LoZioo/Domoticata/README.md

# Domoticata
Custom domotic home system.
