LoZioo/Domoticata/docs/Schema funzionale/Schema funzionale.pdf

AC/DC
12V

AC
220V

ESP32

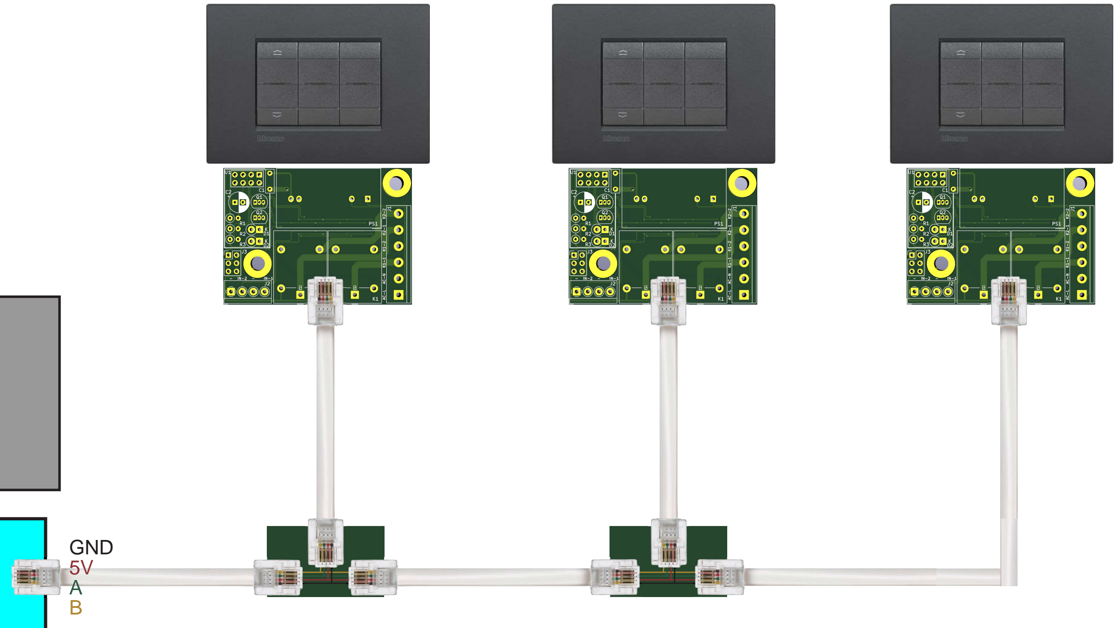
[picture p1: figure]
GND 5VAB

Centralina
