LoZioo/Domoticata/docs/PowerMonitor.docx

P(W)=1/n∑_(i=1)^n (V_i *I_i )

S(VA)=V_(RMS) *I_(RMS)

Q(VAr)=√(S^2 -P^2)

cosφ=P/S
