LoZioo/Domoticata/hardware/img/GND.png

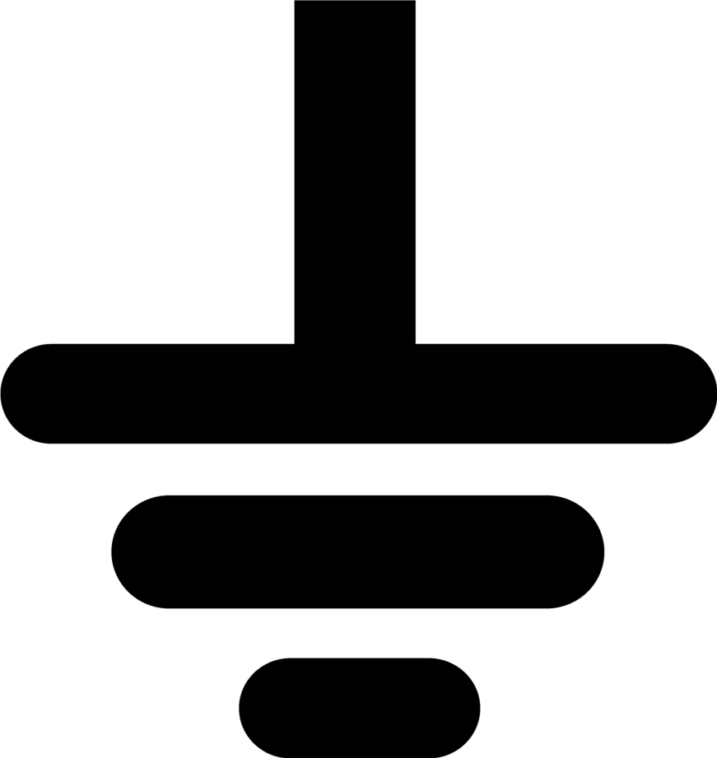
hardware/img/GND.png
