LoZioo/Domoticata/hardware/schematics/DIN_panel/DIN_panel.kicad_pcb

## KiCad design hardware/schematics/DIN_panel/DIN_panel.kicad_pcb (2024-09-18)

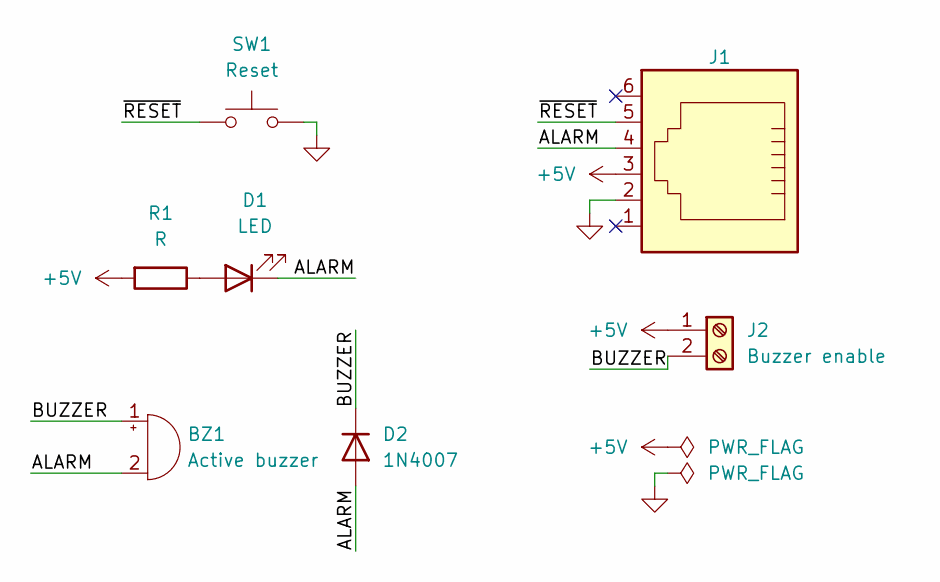
[picture p3: schematic DIN_panel.kicad_sch, Domoticata DIN panel]

Parts:
BZ1: Active buzzer; Buzzer_12x9.5RM7.6
D1: LED; LED_D5.0mm
D2: 1N4007; D_DO-41_SOD81_P7.62mm_Horizontal
J1: 6P6C; RJ25_Wayconn_MJEA-660X1_Horizontal
J2: Buzzer enable; TerminalBlock_4Ucon_1x02_P3.50mm_Horizontal
R1: R; R_Axial_DIN0207_L6.3mm_D2.5mm_P7.62mm_Horizontal
SW1: Reset; SW_PUSH_6mm_H5mm

Connections:
+5V: J1.3, J2.1, R1.2
/ALARM: BZ1.2 (-), D1.1 (K), D2.2 (A), J1.4
/BUZZER: BZ1.1 (+), D2.1 (K), J2.2
/~RESET: J1.5, SW1.1
GND: J1.2, SW1.2
unnamed: D1.2 (A), R1.1

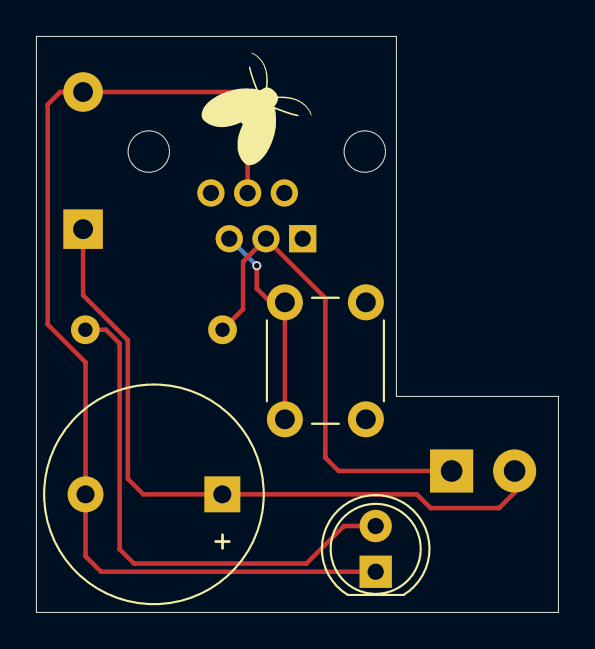
[picture p4: board DIN_panel.kicad_pcb from above]

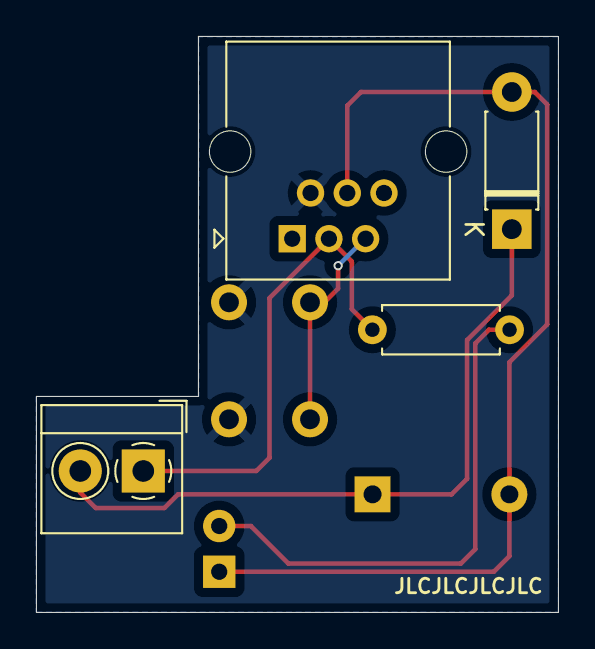
[picture p5: board DIN_panel.kicad_pcb from below]

Board: 2 copper layers, 29.0 x 32.0 mm, 7 parts (4 on the bottom side), 6 nets.
