LoZioo/Domoticata/hardware/schematics/wall_terminal/wall_terminal.kicad_pcb

## KiCad design hardware/schematics/wall_terminal/wall_terminal.kicad_pcb (2024-09-18)

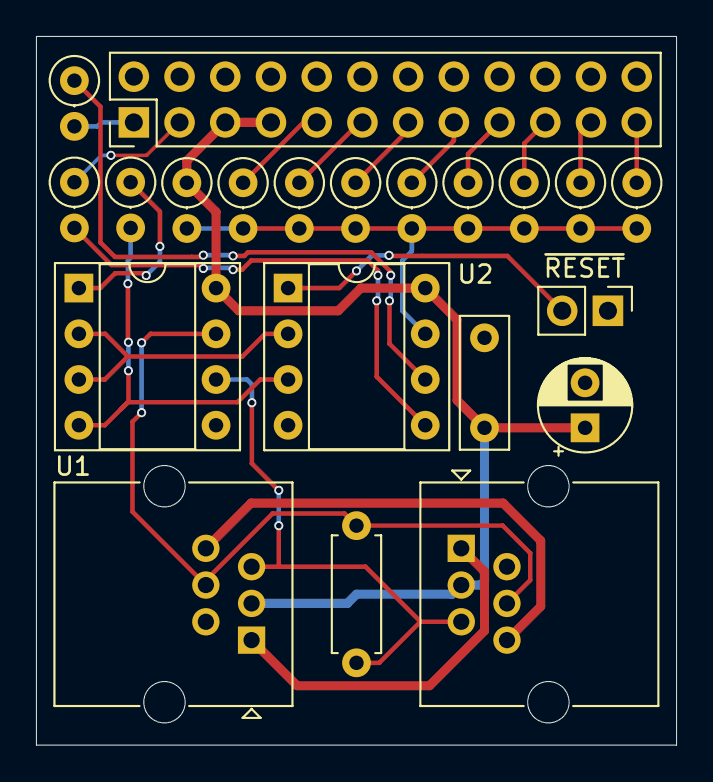
[picture p6: board wall_terminal.kicad_pcb from above]

Board: 2 copper layers, 35.6 x 39.4 mm, 21 parts (0 on the bottom side), 23 nets.

Parts:
C1: 10uF; CP_Radial_D5.0mm_P2.50mm
C2: 100nF; C_Rect_L7.2mm_W2.5mm_P5.00mm_FKS2_FKP2_MKS2_MKP2
J1: Reset; PinHeader_1x02_P2.54mm_Vertical
J2: Conn_02x12_Odd_Even; PinHeader_2x12_P2.54mm_Vertical
J3, J4: 6P6C; RJ25_Wayconn_MJEA-660X1_Horizontal
R1, R2, R3, R4, R5, R6, R7, R8, R9, R10, R11: R; R_Axial_DIN0207_L6.3mm_D2.5mm_P2.54mm_Vertical
R12: 1k; R_Axial_DIN0207_L6.3mm_D2.5mm_P2.54mm_Vertical
R13: 120; R_Axial_DIN0207_L6.3mm_D2.5mm_P7.62mm_Horizontal
U1: MAX487E; DIP-8_W7.62mm_Socket
U2: ATtiny13A-P; DIP-8_W7.62mm_Socket

Connections:
+5V: C1.1, C2.1, J2.5, J2.7, J3.3, J4.3, R11.1, U1.8 (VCC), U2.8 (VCC)
/BUS_SHORT_1: J3.1, J4.1
/BUS_SHORT_6: J3.6, J4.6
/IN/ADC: R3.2, R4.2, R5.2, R6.2, R7.2, R8.2, R9.2, R10.2, R11.2, U2.7 (PB2)
/IN/S1: J2.23, R3.1
/IN/S2: J2.21, R4.1
/IN/S3: J2.19, R5.1
/IN/S4: J2.17, R6.1
/IN/S5: J2.15, R7.1
/IN/S6: J2.13, R8.1
/IN/S7: J2.11, R9.1
/IN/S8: J2.9, R10.1
/MCU/DE/~RE: U1.2 (~RE), U1.3 (DE), U2.2 (PB3)
/MCU/PWM_A: R1.2, U2.5 (PB0)
/MCU/PWM_B: R2.1, U2.6 (PB1)
/MCU/RX/TX: R12.2, U1.4 (DI), U2.3 (PB4)
/MCU/~RST: J1.2, U2.1 (~RESET/PB5)
/RS485_A: J3.5, J4.5, R13.1, U1.6 (A)
/RS485_B: J3.4, J4.4, R13.2, U1.7 (B)
GND: C1.2, C2.2, J1.1, J2.2, J2.4, J2.6, J2.8, J2.10, J2.12, J2.14, J2.16, J2.18, J2.20, J2.22, J2.24, J3.2, J4.2, U1.5 (GND), U2.4 (GND)
unnamed: J2.1, R2.2
unnamed: J2.3, R1.1
unnamed: R12.1, U1.1 (RO)
