LoZioo/Domoticata/hardware/schematics/control_unit/control_unit.kicad_pcb

## KiCad design hardware/schematics/control_unit/control_unit.kicad_pcb (2024-09-18)

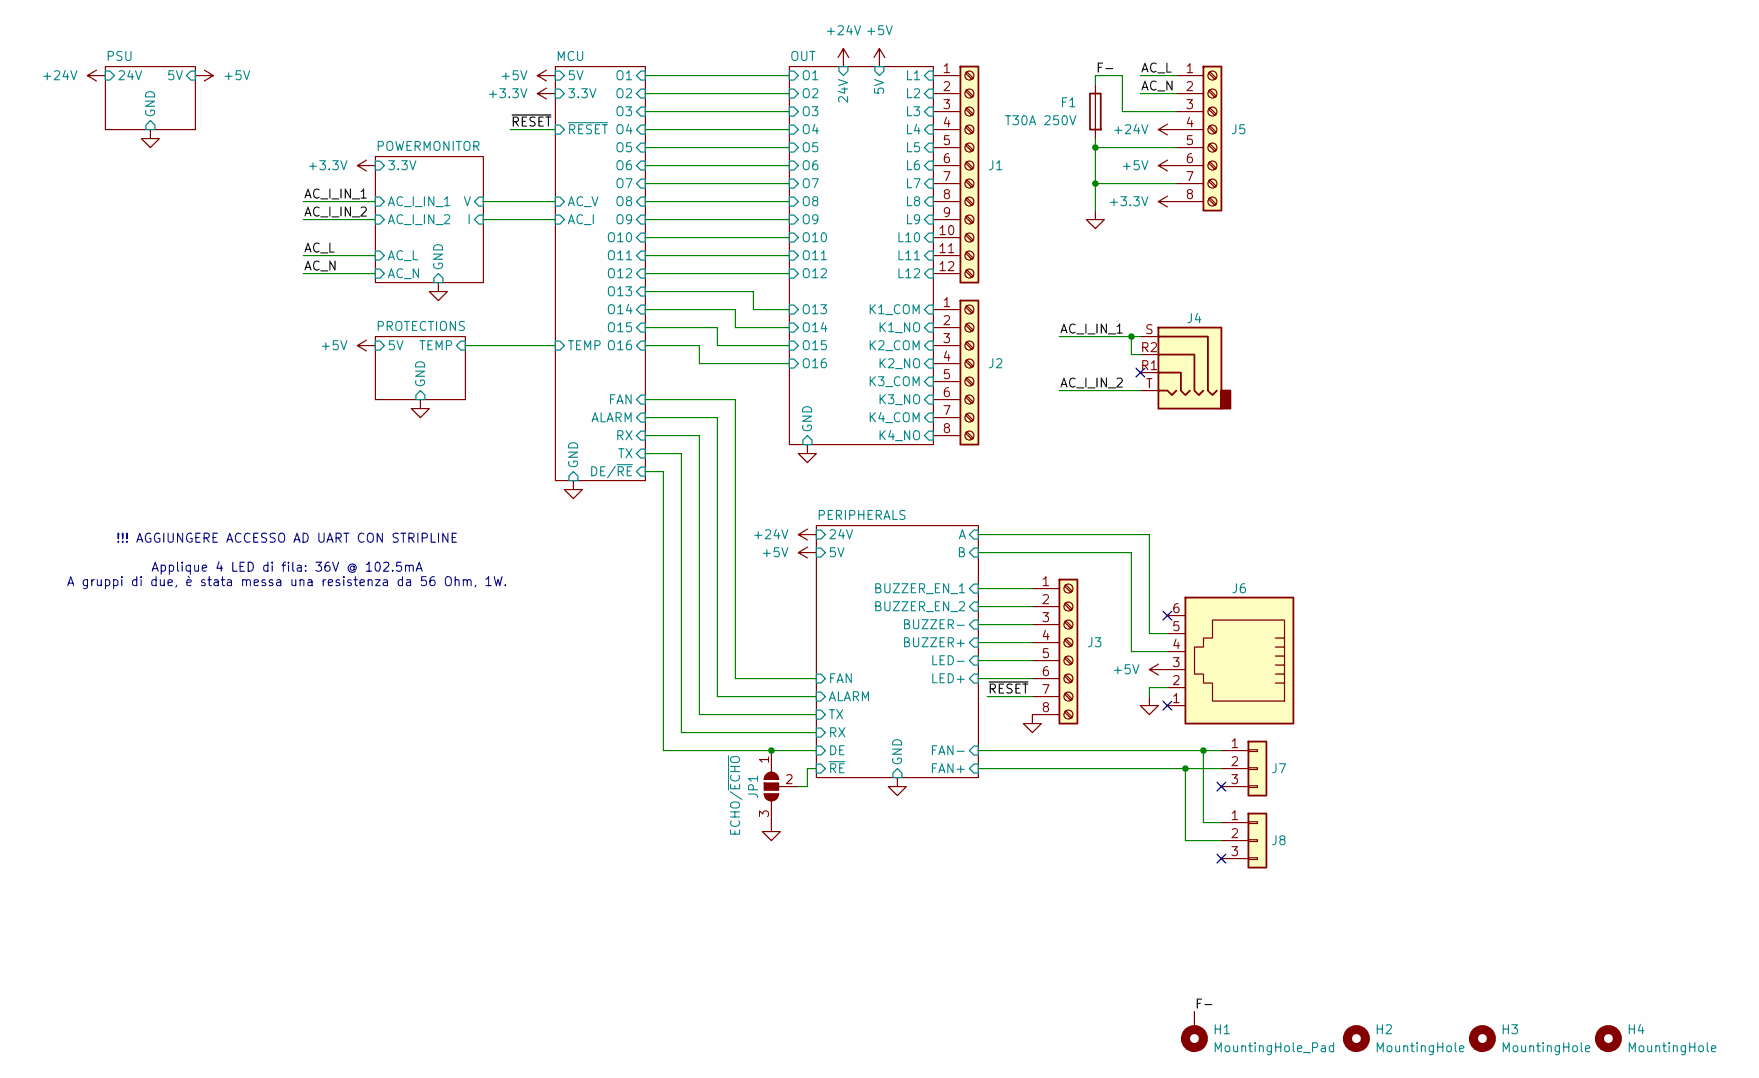
[picture p7: schematic control_unit.kicad_sch, Domoticata main control unit]

Parts:
F1: T30A 250V; Fuseholder_Clip-6.3x32mm_Littelfuse_102_Inline_P34.21x7.62m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
H1: MountingHole_Pad; MountingHole_4.5mm_Pad_TopBottom
H2, H3, H4: MountingHole; MountingHole_4.5mm_Pad_TopBottom
J1: Screw_Terminal_01x12; PhoenixContact_MCV_1,5_12-G-3.81_1x12_P3.81mm_D1.4mm_Vertic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
J2, J3, J5: Screw_Terminal_01x08; PhoenixContact_MCV_1,5_8-G-3.81_1x08_P3.81mm_D1.4mm_Vertical
J4: AudioJack4; SCT013
J6: 6P6C; RJ25_Wayconn_MJEA-660X1_Horizontal
J7, J8: Conn_01x03_Pin; FanPinHeader_1x03_P2.54mm_Vertical
JP1: ECHO/~{ECHO}; SolderJumper-3_P1.3mm_Open_Pad1.0x1.5mm

Connections:
+3.3V: J5.8; also elsewhere on the board
+5V: J3.4, J3.6, J5.6, J6.3; also elsewhere on the board
+24V: J5.4, J7.2, J8.2; also elsewhere on the board
/AC_I_IN_1: J4.R2, J4.S; also elsewhere on the board
/AC_I_IN_2: J4.T; also elsewhere on the board
/AC_L: J5.1; also elsewhere on the board
/AC_N: J5.2; also elsewhere on the board
/F-: F1.1, H1.1, J5.3
/MCU/DE/~RE: JP1.1 (A); also elsewhere on the board
/OUT/K1_COM: J2.1; also elsewhere on the board
/OUT/K1_NO: J2.2; also elsewhere on the board
/OUT/K2_COM: J2.3; also elsewhere on the board
/OUT/K2_NO: J2.4; also elsewhere on the board
/OUT/K3_COM: J2.5; also elsewhere on the board
/OUT/K3_NO: J2.6; also elsewhere on the board
/OUT/K4_COM: J2.7; also elsewhere on the board
/OUT/K4_NO: J2.8; also elsewhere on the board
/OUT/L1: J1.1; also elsewhere on the board
/OUT/L2: J1.2; also elsewhere on the board
/OUT/L3: J1.3; also elsewhere on the board
/OUT/L4: J1.4; also elsewhere on the board
/OUT/L5: J1.5; also elsewhere on the board
/OUT/L6: J1.6; also elsewhere on the board
/OUT/L7: J1.7; also elsewhere on the board
/OUT/L8: J1.8; also elsewhere on the board
/OUT/L9: J1.9; also elsewhere on the board
/OUT/L10: J1.10; also elsewhere on the board
/OUT/L11: J1.11; also elsewhere on the board
/OUT/L12: J1.12; also elsewhere on the board
/PERIPHERALS/A: J6.5; also elsewhere on the board
/PERIPHERALS/B: J6.4; also elsewhere on the board
/PERIPHERALS/BUZZER-: J3.1, J3.3
/PERIPHERALS/BUZZER_EN_2: J3.2; also elsewhere on the board
/PERIPHERALS/FAN-: J7.1, J8.1; also elsewhere on the board
/PERIPHERALS/LED-: J3.5; also elsewhere on the board
/PERIPHERALS/~RE: JP1.2 (C); also elsewhere on the board
/~RESET: J3.7; also elsewhere on the board
GND: F1.2, J3.8, J5.5, J5.7, J6.2, JP1.3 (B); also elsewhere on the board

Notes on the sheet:
!!! AGGIUNGERE ACCESSO AD UART CON STRIPLINE Applique 4 LED di fila: 36V @ 102.5mA A gruppi di due, è stata messa una resistenza da 56 Ohm, 1W.

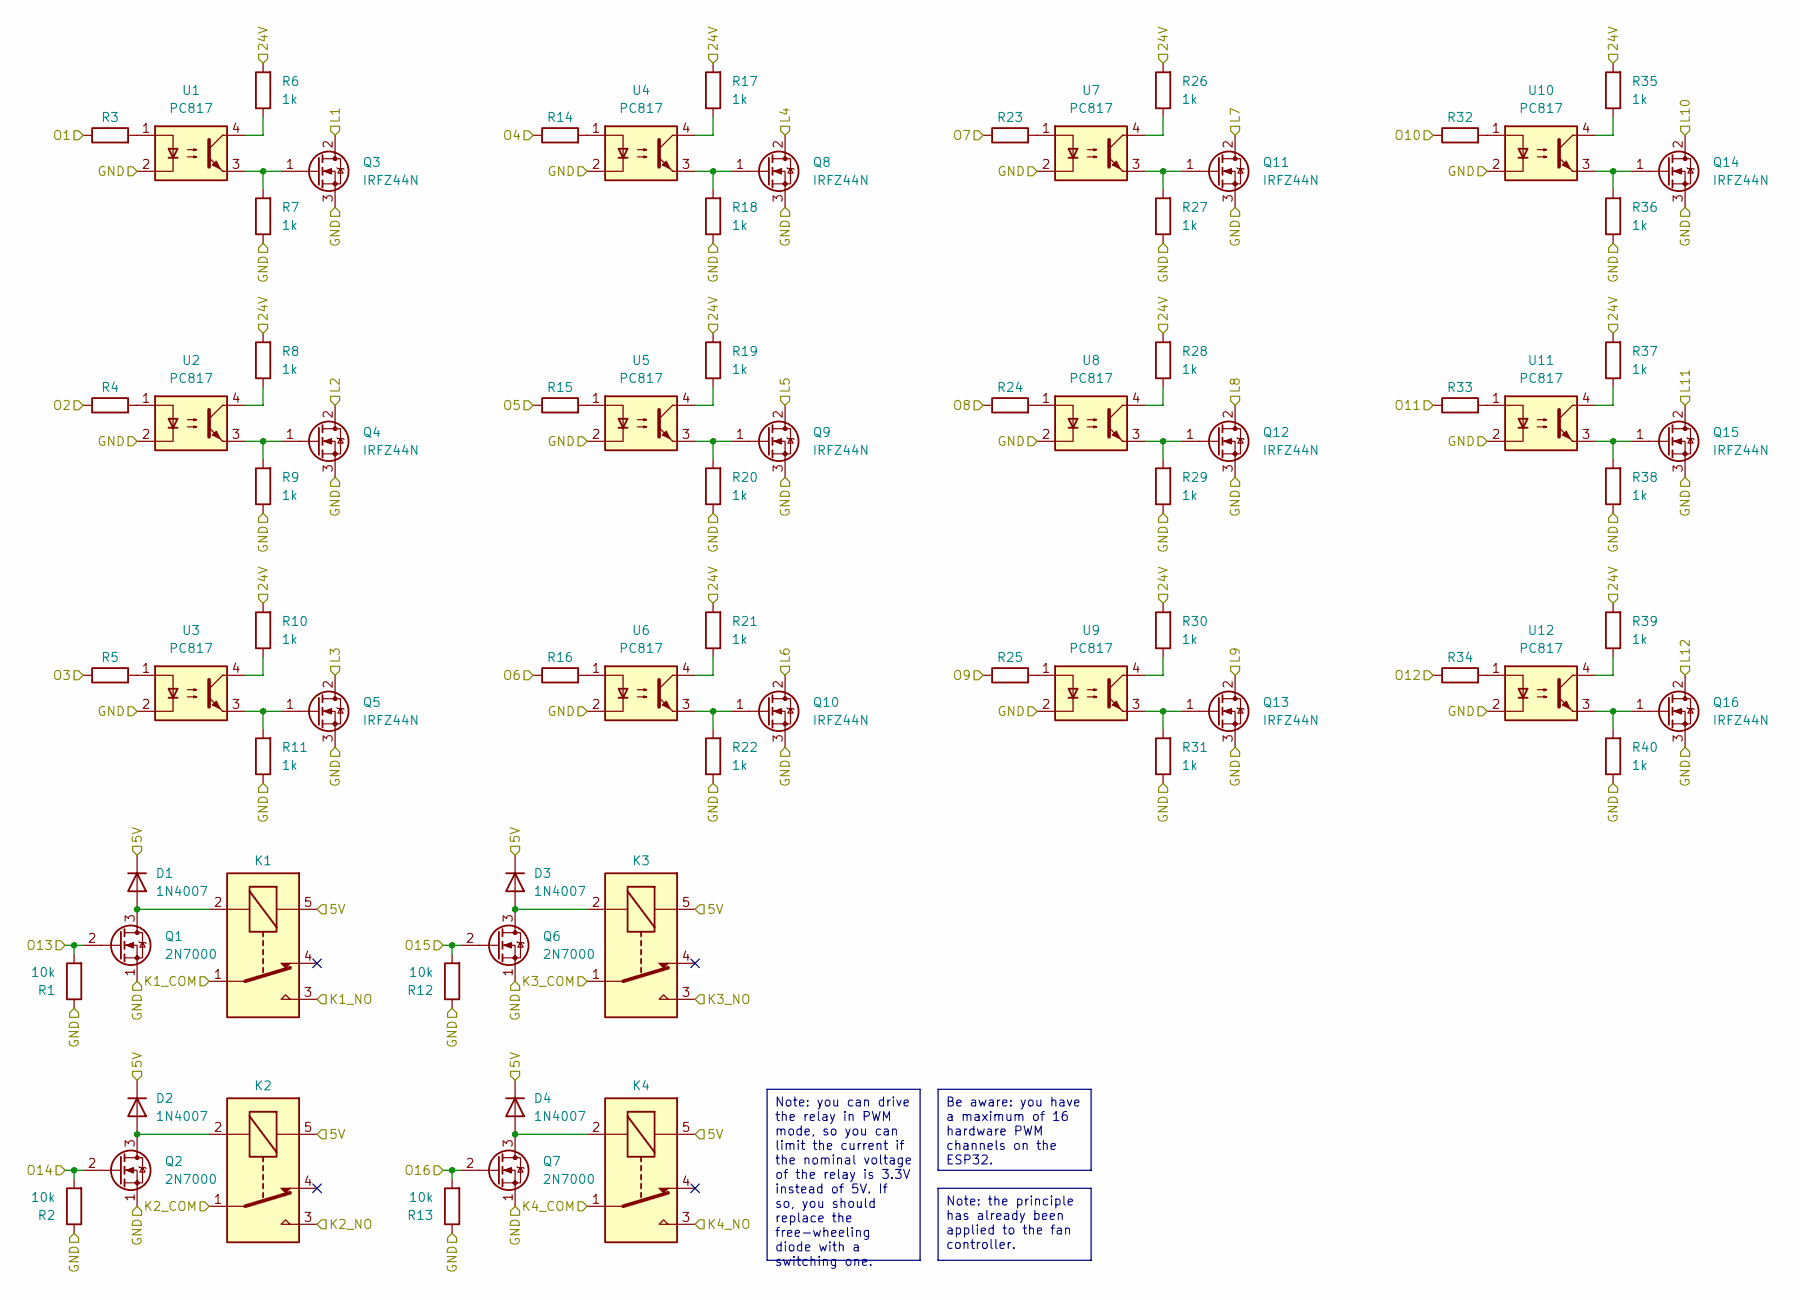
[picture p8: schematic out.kicad_sch, Domoticata main control unit]

Parts:
D1, D2, D3, D4: 1N4007; D_DO-41_SOD81_P7.62mm_Horizontal
K1, K2, K3, K4: Relay_SPDT; Relay_SPDT_Omron-G5LE-1
Q1, Q2, Q6, Q7: 2N7000; TO-92_Inline
Q3, Q4, Q5, Q8, Q9, Q10, Q11, Q12, Q13, Q14, Q15, Q16: IRFZ44N; TO-220-3_Vertical
R1, R2, R12, R13: 10k; R_Axial_DIN0207_L6.3mm_D2.5mm_P7.62mm_Horizontal
R3, R4, R5, R14, R15, R16, R23, R24, R25, R32, R33, R34: R; R_Axial_DIN0207_L6.3mm_D2.5mm_P7.62mm_Horizontal
R6, R7, R8, R9, R10, R11, R17, R18, R19, R20, R21, R22, R26, R27, R28, R29, R30, R31, R35, R36, R37, R38, R39, R40: 1k; R_Axial_DIN0207_L6.3mm_D2.5mm_P7.62mm_Horizontal
U1, U2, U3, U4, U5, U6, U7, U8, U9, U10, U11, U12: PC817; DIP-4_W7.62mm

Connections:
+5V: D1.1 (K), D2.1 (K), D3.1 (K), D4.1 (K), K1.5, K2.5, K3.5, K4.5; also elsewhere on the board
+24V: R6.2, R8.2, R10.2, R17.2, R19.2, R21.2, R26.2, R28.2, R30.2, R35.2, R37.2, R39.2; also elsewhere on the board
/MCU/O1: R3.1; also elsewhere on the board
/MCU/O2: R4.1; also elsewhere on the board
/MCU/O3: R5.1; also elsewhere on the board
/MCU/O4: R14.1; also elsewhere on the board
/MCU/O5: R15.1; also elsewhere on the board
/MCU/O6: R16.1; also elsewhere on the board
/MCU/O7: R23.1; also elsewhere on the board
/MCU/O8: R24.1; also elsewhere on the board
/MCU/O9: R25.1; also elsewhere on the board
/MCU/O10: R32.1; also elsewhere on the board
/MCU/O11: R33.1; also elsewhere on the board
/MCU/O12: R34.1; also elsewhere on the board
/MCU/O13: Q1.2 (G), R1.2; also elsewhere on the board
/MCU/O14: Q2.2 (G), R2.2; also elsewhere on the board
/MCU/O15: Q6.2 (G), R12.2; also elsewhere on the board
/MCU/O16: Q7.2 (G), R13.2; also elsewhere on the board
/OUT/K1_COM: K1.1; also elsewhere on the board
/OUT/K1_NO: K1.3; also elsewhere on the board
/OUT/K2_COM: K2.1; also elsewhere on the board
/OUT/K2_NO: K2.3; also elsewhere on the board
/OUT/K3_COM: K3.1; also elsewhere on the board
/OUT/K3_NO: K3.3; also elsewhere on the board
/OUT/K4_COM: K4.1; also elsewhere on the board
/OUT/K4_NO: K4.3; also elsewhere on the board
/OUT/L1: Q3.2 (D); also elsewhere on the board
/OUT/L2: Q4.2 (D); also elsewhere on the board
/OUT/L3: Q5.2 (D); also elsewhere on the board
/OUT/L4: Q8.2 (D); also elsewhere on the board
/OUT/L5: Q9.2 (D); also elsewhere on the board
/OUT/L6: Q10.2 (D); also elsewhere on the board
/OUT/L7: Q11.2 (D); also elsewhere on the board
/OUT/L8: Q12.2 (D); also elsewhere on the board
/OUT/L9: Q13.2 (D); also elsewhere on the board
/OUT/L10: Q14.2 (D); also elsewhere on the board
/OUT/L11: Q15.2 (D); also elsewhere on the board
/OUT/L12: Q16.2 (D); also elsewhere on the board
GND: Q1.1 (S), Q2.1 (S), Q3.3 (S), Q4.3 (S), Q5.3 (S), Q6.1 (S), Q7.1 (S), Q8.3 (S), Q9.3 (S), Q10.3 (S), Q11.3 (S), Q12.3 (S), Q13.3 (S), Q14.3 (S), Q15.3 (S), Q16.3 (S), R1.1, R2.1, R7.1, R9.1, R11.1, R12.1, R13.1, R18.1, R20.1, R22.1, R27.1, R29.1, R31.1, R36.1, R38.1, R40.1, U1.2, U2.2, U3.2, U4.2, U5.2, U6.2, U7.2, U8.2, U9.2, U10.2, U11.2, U12.2; also elsewhere on the board
unnamed: D1.2 (A), K1.2, Q1.3 (D)
unnamed: D2.2 (A), K2.2, Q2.3 (D)
unnamed: D3.2 (A), K3.2, Q6.3 (D)
unnamed: D4.2 (A), K4.2, Q7.3 (D)
unnamed: Q3.1 (G), R7.2, U1.3
unnamed: Q4.1 (G), R9.2, U2.3
unnamed: Q5.1 (G), R11.2, U3.3
unnamed: Q8.1 (G), R18.2, U4.3
unnamed: Q9.1 (G), R20.2, U5.3
unnamed: Q10.1 (G), R22.2, U6.3
unnamed: Q11.1 (G), R27.2, U7.3
unnamed: Q12.1 (G), R29.2, U8.3
unnamed: Q13.1 (G), R31.2, U9.3
unnamed: Q14.1 (G), R36.2, U10.3
unnamed: Q15.1 (G), R38.2, U11.3
unnamed: Q16.1 (G), R40.2, U12.3
unnamed: R3.2, U1.1
unnamed: R4.2, U2.1
unnamed: R5.2, U3.1
unnamed: R6.1, U1.4
unnamed: R8.1, U2.4
unnamed: R10.1, U3.4
unnamed: R14.2, U4.1
unnamed: R15.2, U5.1
unnamed: R16.2, U6.1
unnamed: R17.1, U4.4
unnamed: R19.1, U5.4
unnamed: R21.1, U6.4
unnamed: R23.2, U7.1
unnamed: R24.2, U8.1
unnamed: R25.2, U9.1
unnamed: R26.1, U7.4
unnamed: R28.1, U8.4
unnamed: R30.1, U9.4
unnamed: R32.2, U10.1
unnamed: R33.2, U11.1
unnamed: R34.2, U12.1
unnamed: R35.1, U10.4
unnamed: R37.1, U11.4
unnamed: R39.1, U12.4

Notes on the sheet:
Note: you can drive the relay in PWM mode, so you can limit the current if the nominal voltage of the relay is 3.3V instead of 5V. If so, you should replace the free-wheeling diode with a switching one.
Be aware: you have a maximum of 16 hardware PWM channels on the ESP32.
Note: the principle has already been applied to the fan controller.

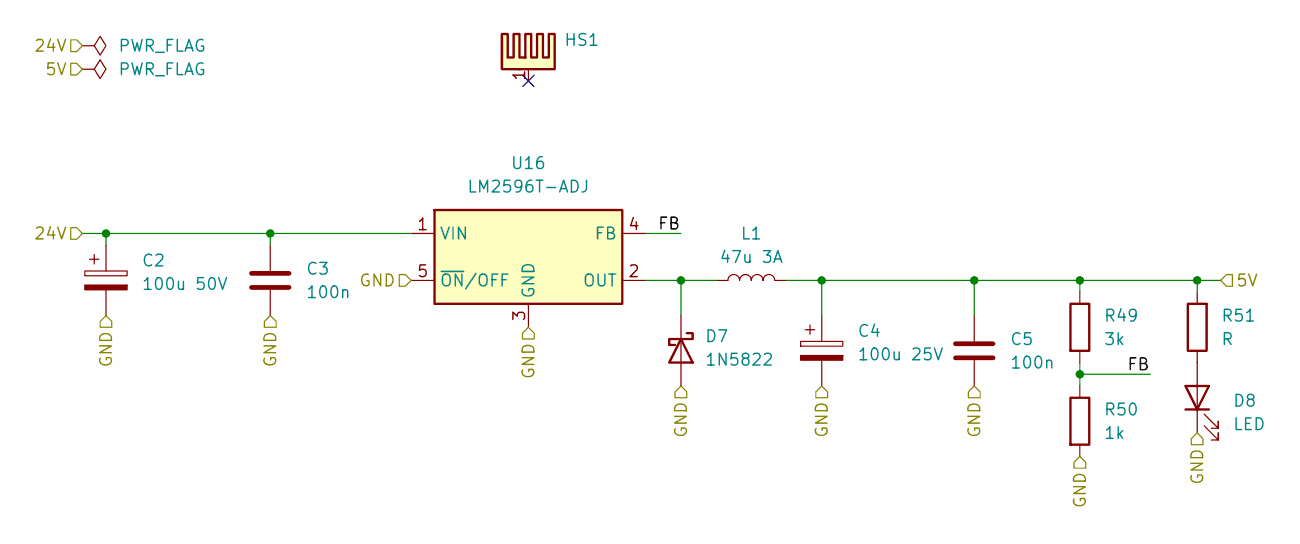
[picture p9: schematic psu.kicad_sch, Domoticata main control unit]

Parts:
C2: 100u 50V; CP_Radial_D8.0mm_P3.80mm
C3, C5: 100n; C_Rect_L7.2mm_W2.5mm_P5.00mm_FKS2_FKP2_MKS2_MKP2
C4: 100u 25V; CP_Radial_D6.3mm_P2.50mm
D7: 1N5822; D_DO-201AD_P12.70mm_Horizontal
D8: LED; LED_D5.0mm
HS1: Heatsink_Pad; Heatsink_Custom_1
L1: 47u 3A; L_Toroid_Vertical_L14.7mm_W8.6mm_P5.58mm_Pulse_KM-1
R49: 3k; R_Axial_DIN0207_L6.3mm_D2.5mm_P7.62mm_Horizontal
R50: 1k; R_Axial_DIN0207_L6.3mm_D2.5mm_P7.62mm_Horizontal
R51: R; R_Axial_DIN0207_L6.3mm_D2.5mm_P7.62mm_Horizontal
U16: LM2596T-ADJ; TO-220-5_Vertical

Connections:
+5V: C4.1, C5.1, L1.2, R49.1, R51.2; also elsewhere on the board
+24V: C2.1, C3.1, U16.1 (VIN); also elsewhere on the board
/PSU/FB: R49.2, R50.1, U16.4 (FB)
GND: C2.2, C3.2, C4.2, C5.2, D7.2 (A), D8.1 (K), R50.2, U16.3 (GND), U16.5 (~ON/OFF); also elsewhere on the board
unnamed: D7.1 (K), L1.1, U16.2 (OUT)
unnamed: D8.2 (A), R51.1

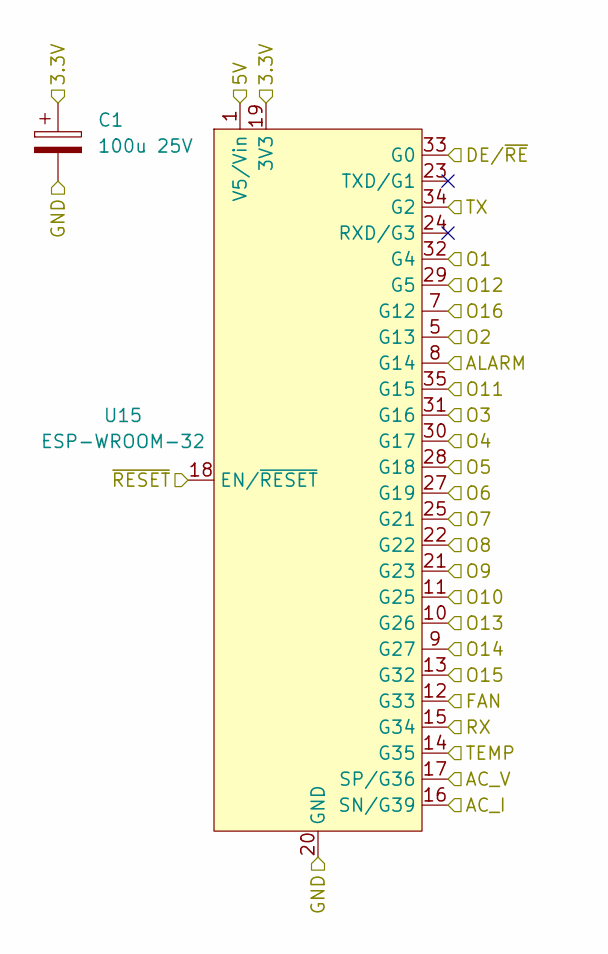
[picture p10: schematic mcu.kicad_sch, Domoticata main control unit]

Parts:
C1: 100u 25V; CP_Radial_D6.3mm_P2.50mm
U15: ESP-WROOM-32; ESP32_38PIN

Connections:
+3.3V: C1.1, U15.19 (3V3); also elsewhere on the board
+5V: U15.1 (V5/Vin); also elsewhere on the board
/MCU/AC_I: U15.16 (SN/G39); also elsewhere on the board
/MCU/AC_V: U15.17 (SP/G36); also elsewhere on the board
/MCU/ALARM: U15.8 (G14); also elsewhere on the board
/MCU/DE/~RE: U15.33 (G0); also elsewhere on the board
/MCU/FAN: U15.12 (G33); also elsewhere on the board
/MCU/O1: U15.32 (G4); also elsewhere on the board
/MCU/O2: U15.5 (G13); also elsewhere on the board
/MCU/O3: U15.31 (G16); also elsewhere on the board
/MCU/O4: U15.30 (G17); also elsewhere on the board
/MCU/O5: U15.28 (G18); also elsewhere on the board
/MCU/O6: U15.27 (G19); also elsewhere on the board
/MCU/O7: U15.25 (G21); also elsewhere on the board
/MCU/O8: U15.22 (G22); also elsewhere on the board
/MCU/O9: U15.21 (G23); also elsewhere on the board
/MCU/O10: U15.11 (G25); also elsewhere on the board
/MCU/O11: U15.35 (G15); also elsewhere on the board
/MCU/O12: U15.29 (G5); also elsewhere on the board
/MCU/O13: U15.10 (G26); also elsewhere on the board
/MCU/O14: U15.9 (G27); also elsewhere on the board
/MCU/O15: U15.13 (G32); also elsewhere on the board
/MCU/O16: U15.7 (G12); also elsewhere on the board
/MCU/RX: U15.15 (G34); also elsewhere on the board
/MCU/TEMP: U15.14 (G35); also elsewhere on the board
/MCU/TX: U15.34 (G2); also elsewhere on the board
/~RESET: U15.18 (EN/~RESET); also elsewhere on the board
GND: C1.2, U15.6 (GND), U15.20 (GND), U15.26 (GND); also elsewhere on the board

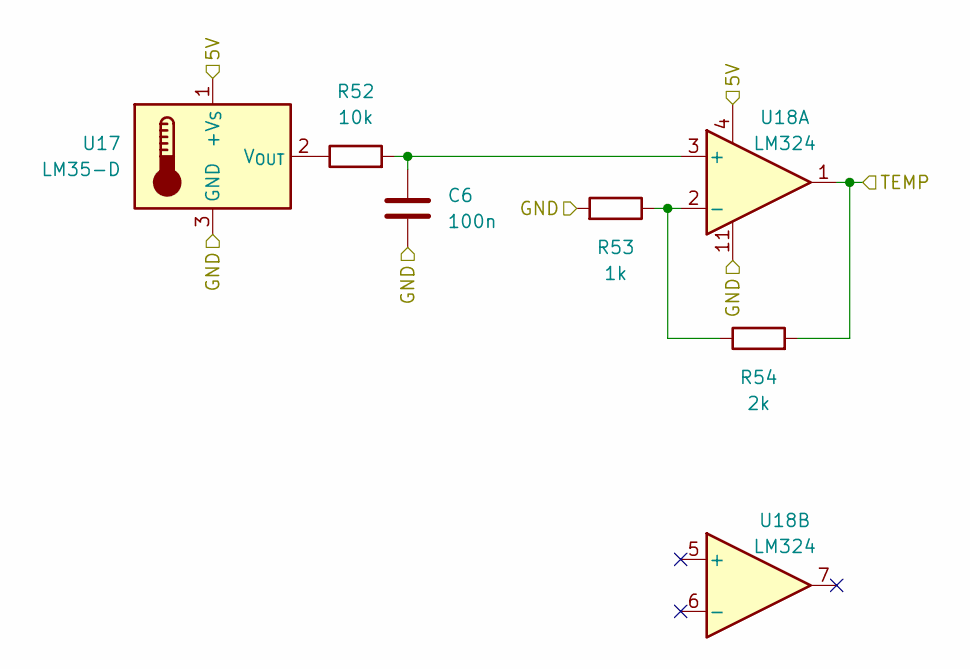
[picture p11: schematic protections.kicad_sch, Domoticata main control unit]

Parts:
C6: 100n; C_Rect_L7.2mm_W2.5mm_P5.00mm_FKS2_FKP2_MKS2_MKP2
R52: 10k; R_Axial_DIN0207_L6.3mm_D2.5mm_P7.62mm_Horizontal
R53: 1k; R_Axial_DIN0207_L6.3mm_D2.5mm_P7.62mm_Horizontal
R54: 2k; R_Axial_DIN0207_L6.3mm_D2.5mm_P7.62mm_Horizontal
U17: LM35-D; TO-92_Inline
U18: LM324; DIP-14_W7.62mm_Socket

Connections:
+5V: U17.1 (+V_{S}), U18.4 (V+); also elsewhere on the board
/MCU/TEMP: R54.2, U18.1; also elsewhere on the board
GND: C6.2, R53.2, U17.3 (GND), U18.11 (V-); also elsewhere on the board
unnamed: R52.1, U17.2 (V_{OUT})
unnamed: C6.1, R52.2, U18.3 (+)
unnamed: R53.1, R54.1, U18.2 (-)

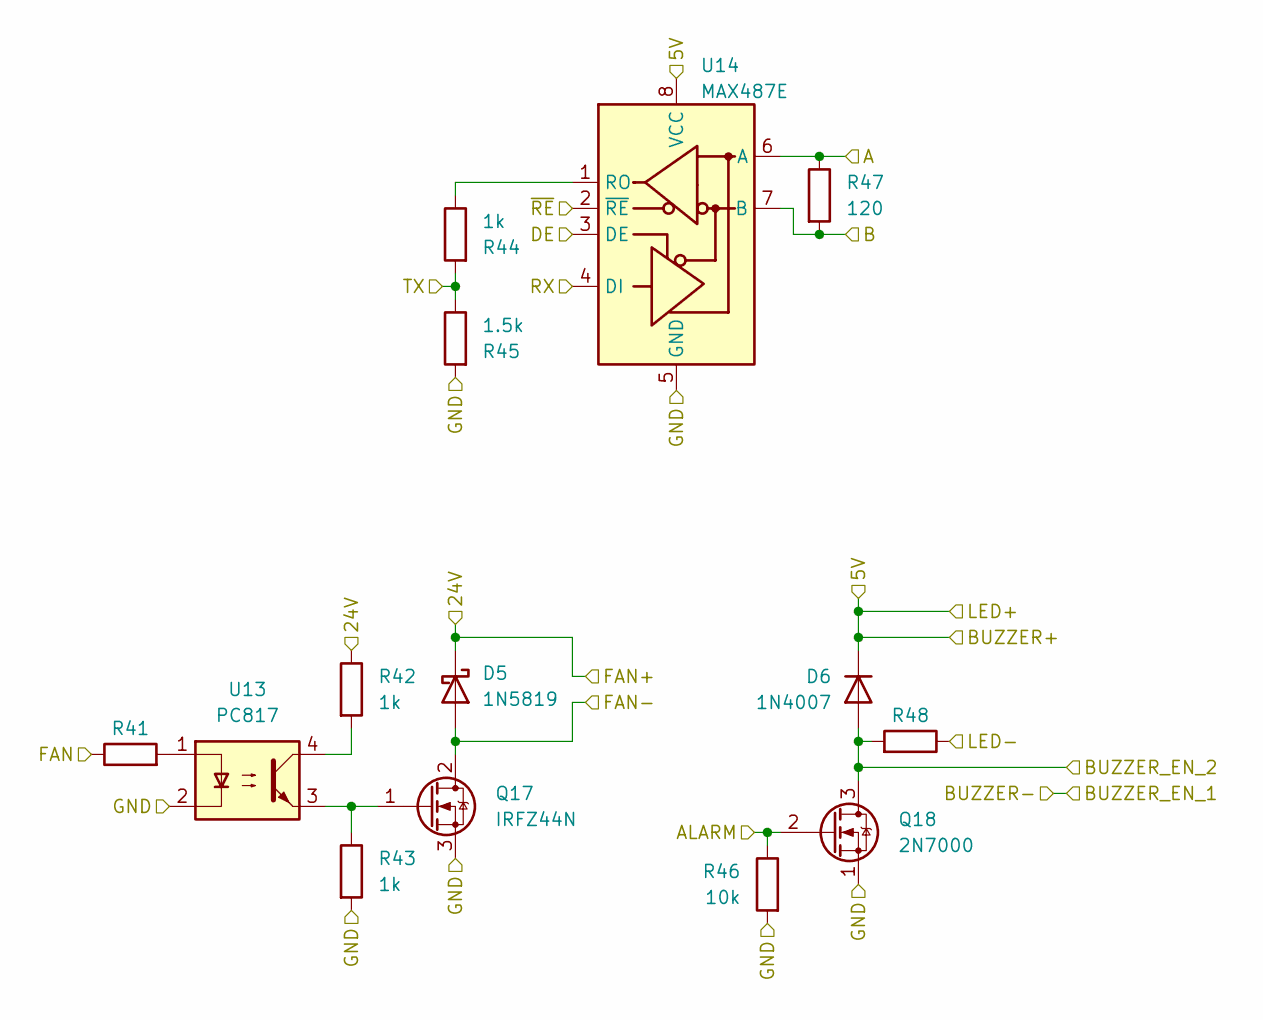
[picture p12: schematic peripherals.kicad_sch, Domoticata main control unit]

Parts:
D5: 1N5819; D_DO-41_SOD81_P7.62mm_Horizontal
D6: 1N4007; D_DO-41_SOD81_P7.62mm_Horizontal
Q17: IRFZ44N; TO-220-3_Vertical
Q18: 2N7000; TO-92_Inline
R41, R48: R; R_Axial_DIN0207_L6.3mm_D2.5mm_P7.62mm_Horizontal
R42, R43, R44: 1k; R_Axial_DIN0207_L6.3mm_D2.5mm_P7.62mm_Horizontal
R45: 1.5k; R_Axial_DIN0207_L6.3mm_D2.5mm_P7.62mm_Horizontal
R46: 10k; R_Axial_DIN0207_L6.3mm_D2.5mm_P7.62mm_Horizontal
R47: 120; R_Axial_DIN0207_L6.3mm_D2.5mm_P7.62mm_Horizontal
U13: PC817; DIP-4_W7.62mm
U14: MAX487E; DIP-8_W7.62mm_Socket

Connections:
+5V: D6.1 (K), U14.8 (VCC); also elsewhere on the board
+24V: D5.1 (K), R42.1; also elsewhere on the board
/MCU/ALARM: Q18.2 (G), R46.1; also elsewhere on the board
/MCU/DE/~RE: U14.3 (DE); also elsewhere on the board
/MCU/FAN: R41.1; also elsewhere on the board
/MCU/RX: R44.2, R45.1; also elsewhere on the board
/MCU/TX: U14.4 (DI); also elsewhere on the board
/PERIPHERALS/A: R47.1, U14.6 (A); also elsewhere on the board
/PERIPHERALS/B: R47.2, U14.7 (B); also elsewhere on the board
/PERIPHERALS/BUZZER_EN_2: D6.2 (A), Q18.3 (D), R48.2; also elsewhere on the board
/PERIPHERALS/FAN-: D5.2 (A), Q17.2 (D); also elsewhere on the board
/PERIPHERALS/LED-: R48.1; also elsewhere on the board
/PERIPHERALS/~RE: U14.2 (~RE); also elsewhere on the board
GND: Q17.3 (S), Q18.1 (S), R43.2, R45.2, R46.2, U13.2, U14.5 (GND); also elsewhere on the board
unnamed: Q17.1 (G), R43.1, U13.3
unnamed: R41.2, U13.1
unnamed: R42.2, U13.4
unnamed: R44.1, U14.1 (RO)

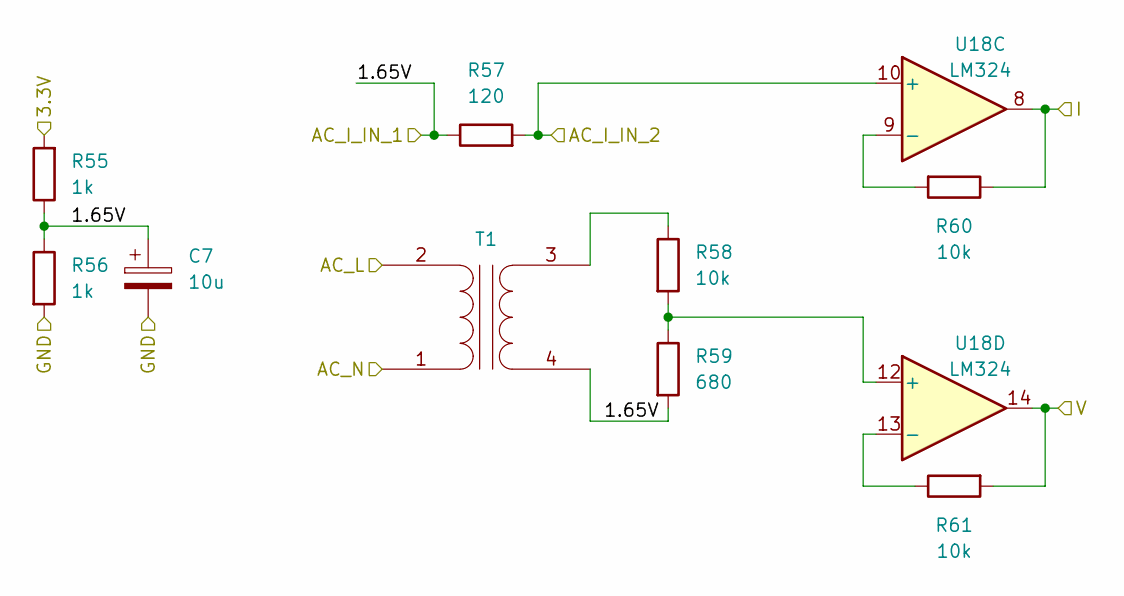
[picture p13: schematic powermonitor.kicad_sch, Domoticata main control unit]

Parts:
C7: 10u; CP_Radial_D4.0mm_P2.00mm
R55, R56: 1k; R_Axial_DIN0207_L6.3mm_D2.5mm_P7.62mm_Horizontal
R57: 120; R_Axial_DIN0207_L6.3mm_D2.5mm_P7.62mm_Horizontal
R58, R60, R61: 10k; R_Axial_DIN0207_L6.3mm_D2.5mm_P7.62mm_Horizontal
R59: 680; R_Axial_DIN0207_L6.3mm_D2.5mm_P7.62mm_Horizontal
T1: Transformer_1P_1S; Transformer
U18: LM324; DIP-14_W7.62mm_Socket

Connections:
+3.3V: R55.2; also elsewhere on the board
/AC_I_IN_1: C7.1, R55.1, R56.1, R57.1, R59.2, T1.4 (SB); also elsewhere on the board
/AC_I_IN_2: R57.2, U18.10 (+); also elsewhere on the board
/AC_L: T1.2 (AB); also elsewhere on the board
/AC_N: T1.1 (AA); also elsewhere on the board
/MCU/AC_I: R60.1, U18.8; also elsewhere on the board
/MCU/AC_V: R61.2, U18.14; also elsewhere on the board
GND: C7.2, R56.2; also elsewhere on the board
unnamed: R58.1, T1.3 (SA)
unnamed: R60.2, U18.9 (-)
unnamed: R58.2, R59.1, U18.12 (+)
unnamed: R61.1, U18.13 (-)

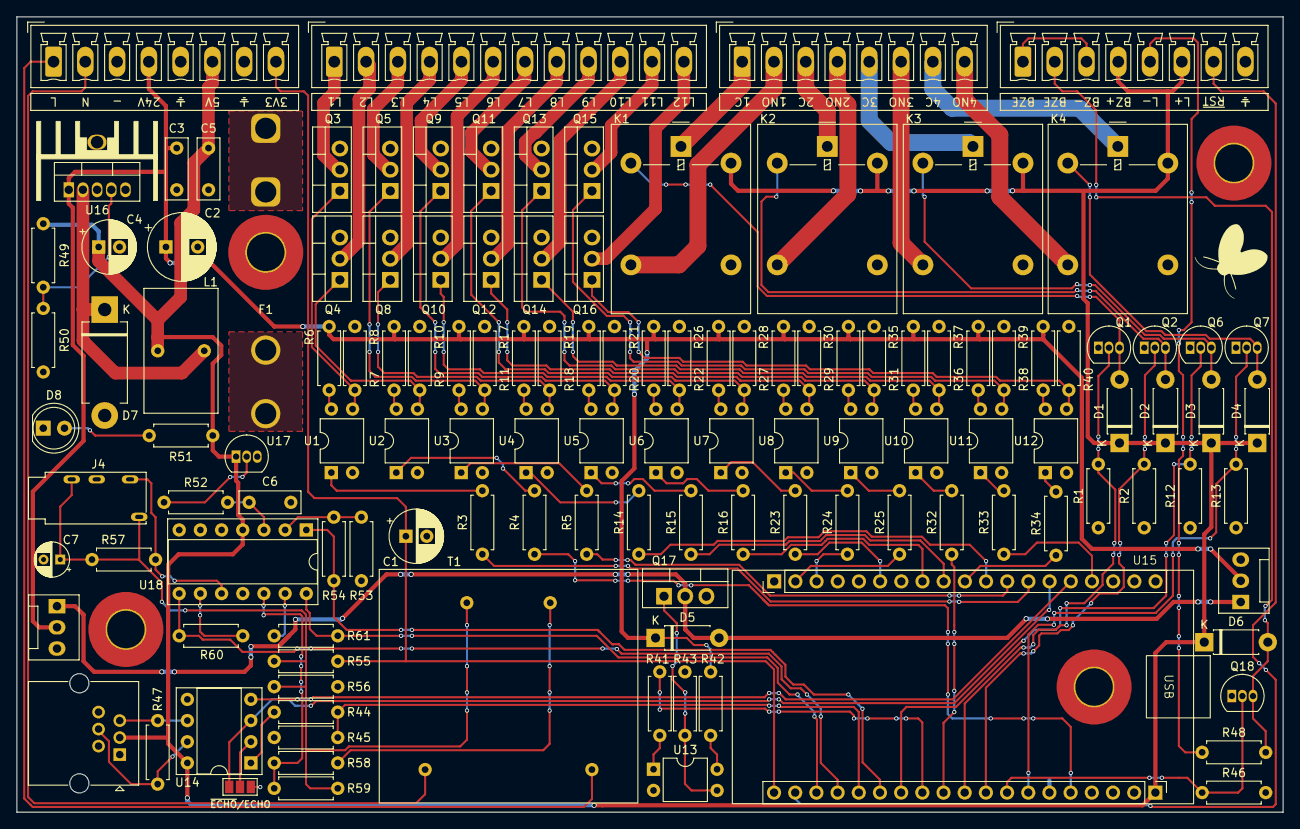
[picture p14: board control_unit.kicad_pcb from above]

Board: 2 copper layers, 151.8 x 95.4 mm, 133 parts (0 on the bottom side), 115 nets.
