LoZioo/Domoticata/src/control_unit/main/src/main.c

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

/* Includes ------------------------------------------------------------------*/
/* USER CODE BEGIN Includes */

// Standard libraries.
#include <stdio.h>
#include <stdlib.h>
#include <stdint.h>
#include <stdbool.h>
#include <string.h>

// Platform libraries.
#include <esp_err.h>
#include <esp_check.h>
#include <esp_log.h>
#include <esp_system.h>

// Project libraries.
#include <main.h>
#include <gpio.h>
#include <rs485.h>
#include <pwm.h>
#include <wifi.h>
#include <fs.h>
#include <webserver.h>
#include <pm.h>

/* USER CODE END Includes */

/* USER CODE BEGIN PD */

// 0 - 1023
#define PWM_FAN_SPEED				512
#define PWM_FAN_SPEED_PERC	( \
	(uint16_t) ( ((float) PWM_FAN_SPEED / (float) PWM_DUTY_MAX) * 100) \
)

/* USER CODE END PD */

/* USER CODE BEGIN PV */

const char *TAG = "main";

/* USER CODE END PV */

/**
 * @brief App entry point.
*/
void app_main(){

	/* MCU Configuration--------------------------------------------------------*/
	/* USER CODE BEGIN SysInit */

	ESP_LOGI(TAG, "Started");

	ESP_LOGI(TAG, "gpio_setup()");
	ESP_ERROR_CHECK(gpio_setup());

	ESP_LOGI(TAG, "pwm_setup()");
	ESP_ERROR_CHECK(pwm_setup());

	led_startup_routine();

	ESP_LOGI(TAG, "Starting fan: speed %u%%", PWM_FAN_SPEED_PERC);
	ESP_ERROR_CHECK(pwm_set_fan(PWM_FAN_SPEED));

	ESP_LOGI(TAG, "rs485_setup()");
	ESP_ERROR_CHECK(rs485_setup());

	// ESP_LOGI(TAG, "nvs_setup()");
	// ESP_ERROR_CHECK(nvs_setup());

	// ESP_LOGI(TAG, "wifi_setup()");
	// ESP_ERROR_CHECK(wifi_setup());

	// ESP_LOGI(TAG, "fs_setup()");
	// ESP_ERROR_CHECK(fs_setup());

	// ESP_LOGI(TAG, "webserver_setup()");
	// ESP_ERROR_CHECK(webserver_setup());

	// ESP_LOGI(TAG, "pm_setup()");
	// ESP_ERROR_CHECK(pm_setup());

	/* USER CODE END SysInit */

	/* USER CODE BEGIN Init */

	ESP_LOGI(TAG, "Completed");
	vTaskDelete(NULL);
	return;

	/* USER CODE END Init */

	/* USER CODE BEGIN 1 */

	/* Infinite loop */
	// for(;;){
	// 	delay(1);
	// }
	/* USER CODE END 1 */
}

/* USER CODE BEGIN 2 */

void led_startup_routine(){

	uint8_t val;
	for(uint8_t i=0; i<6; i++){
		val = 1 - i % 2;
		for(uint8_t zone=ZONE_LED_1; zone<=ZONE_LED_8; zone++){
			gpio_write_zone(zone, val);
			pwm_write_zone(zone, PWM_DUTY_MAX * val, 100);
		}

		delay(100);
	}
}

void delay_remainings(int32_t ms, int64_t initial_timestamp_ms){
	ms -= millis() - initial_timestamp_ms;
	if(ms > 0)
		delay(ms);
}

void log_hash(const char *TAG, const char* label, uint8_t *hash, uint16_t hash_len){

	char str[hash_len * 2 + 1];
	str[sizeof(str) - 1] = 0;

	for(uint16_t i=0; i<hash_len; i++)
		snprintf(&str[i * 2], hash_len, "%02x", hash[i]);

	ESP_LOGI(TAG, "%s: %s", label, str);
}

/* USER CODE END 2 */
