LoZioo/Domoticata/src/control_unit/main/include/webserver.h

/** @file webserver.h
 *  @brief  Created on: Sep 9, 2024
 *          Davide Scalisi
 *
 * 					Description:	Webserver code.
 *
 * @copyright [2024] Davide Scalisi *
 * @copyright All Rights Reserved. *
 *
*/

#ifndef INC_WEBSERVER_H_
#define INC_WEBSERVER_H_

/************************************************************************************************************
* Included files
************************************************************************************************************/

// Standard libraries.
#include <stdio.h>
#include <stdlib.h>
#include <stdint.h>
#include <stdbool.h>
#include <string.h>
#include <errno.h>
#include <sys/socket.h>
#include <netinet/in.h>
#include <arpa/inet.h>

// Platform libraries.
#include <esp_err.h>
#include <esp_check.h>
#include <esp_log.h>

#include <esp_http_server.h>
#include <esp_netif_ip_addr.h>

#include <cJSON.h>

// UniLibC libraries.
#include <ul_errors.h>
#include <ul_utils.h>
#include <ul_pm.h>

// Project libraries.
#include <main.h>
#include <wifi.h>
#include <fs.h>
#include <pm.h>

/************************************************************************************************************
* Public Defines
************************************************************************************************************/

/************************************************************************************************************
* Public Types Definitions
************************************************************************************************************/

/************************************************************************************************************
* Public Variables Prototypes
************************************************************************************************************/

/************************************************************************************************************
* Public Functions Prototypes
************************************************************************************************************/

/**
 * @brief Initialize the library.
 */
extern esp_err_t webserver_setup();

#endif  /* INC_WEBSERVER_H_ */
