LoZioo/Domoticata/src/control_unit/main/include/ota.h

/** @file ota.h
 *  @brief  Created on: Aug 29, 2024
 *          Davide Scalisi
 *
 * 					Description:	OTA update code.
 *
 * @copyright [2024] Davide Scalisi *
 * @copyright All Rights Reserved. *
 *
*/

#ifdef CONFIG_OTA_ENABLED

#ifndef INC_OTA_H_
#define INC_OTA_H_

/************************************************************************************************************
* Included files
************************************************************************************************************/

// Standard libraries.
#include <stdio.h>
#include <stdlib.h>
#include <stdint.h>
#include <stdbool.h>
#include <string.h>
#include <errno.h>

// Platform libraries.
#include <esp_err.h>
#include <esp_check.h>
#include <esp_log.h>

#include <esp_system.h>
#include <esp_ota_ops.h>
#include <esp_app_format.h>
#include <esp_flash_partitions.h>
#include <esp_partition.h>
#include <esp_http_client.h>
#include <esp_netif_ip_addr.h>

#include <freertos/FreeRTOS.h>

// Project libraries.
#include <main.h>
#include <wifi.h>
#include <fs.h>

/************************************************************************************************************
* Public Defines
************************************************************************************************************/

/************************************************************************************************************
* Public Types Definitions
************************************************************************************************************/

/************************************************************************************************************
* Public Variables Prototypes
************************************************************************************************************/

/************************************************************************************************************
* Public Functions Prototypes
************************************************************************************************************/

/**
 * @brief Trigger a filesystem update.
 * @note Call `fs_partition_swap()` from "fs.h" to mount the updated filesystem partition.
 */
extern esp_err_t ota_update_fs(esp_ip4_addr_t ota_server_ip);

/**
 * @brief Trigger a firmware update.
 * @note Call `esp_restart()` from "esp_system.h" to reboot the system to the newly updated firmware.
 */
extern esp_err_t ota_update_fw(esp_ip4_addr_t ota_server_ip);

#endif  /* INC_OTA_H_ */
#endif  /* CONFIG_OTA_ENABLED */
