LoZioo/Domoticata/src/wall_terminal/include/conf_var.h

/** @file conf_var.h
 *  @brief  Created on: July 28, 2024
 *          Davide Scalisi
 *
 * 					Description:	Domoticata wall terminal variable configurations.
 *
 * @copyright [2024] Davide Scalisi *
 * @copyright All Rights Reserved. *
 *
*/

#ifndef INC_CONF_VAR_H_
#define INC_CONF_VAR_H_

// RS-485 device ID up to 127 or 0x7F.
#define CONFIG_RS485_DEVICE_ID	0

#endif  /* INC_CONF_VAR_H_ */
