LoZioo/Domoticata/(commit log)

2024-07-12 feat: first wall terminal PCB prototype without copper traces.
    [wall_terminal.kicad_pcb, wall_terminal.kicad_sch]
2024-07-13 !feat: first wall terminal PCB prototype.
    [wall_terminal.kicad_pcb, wall_terminal.kicad_sch]
2024-07-14 feat: ESP32 38 pin symbol and footprint.
2024-07-14 chore: moved files.
    [wall_terminal.kicad_pcb, wall_terminal.kicad_sch]
2024-07-25 fix: added optional resistors on PWM outputs.
    [in.kicad_sch, mcu.kicad_sch, peripherals.kicad_sch, wall_terminal.kicad_pcb, wall_terminal.kicad_sch]
2024-07-25 chore: added gnd image.
2024-07-25 feat: final PCB topological design.
    [control_unit.kicad_pcb, control_unit.kicad_sch]
2024-07-25 !feat: control_unit first PCB release.
    [control_unit.kicad_pcb, control_unit.kicad_sch, psu.kicad_sch]
2024-07-26 chore: rotated silkscreens.
    [control_unit.kicad_pcb]
2024-07-26 !feat: DIN panel.
    [DIN_panel.kicad_pcb, DIN_panel.kicad_sch]
2024-07-28 feat: add analog button tuner environment.
2024-07-29 feat: added minimal button states library.
2024-07-31 fix: forced to output the uart pins
    [const.h, main.cpp]
2024-08-03 feat: UART_setup()
2024-08-03 feat: first UART_poll() implementation
2024-08-06 feat: begin thread oriented implementation.
2024-08-06 feat: delay to stabilize the peripherals
    [main.cpp]
2024-08-06 feat: ledc initialization
2024-08-06 !feat: pwm fade test code.
2024-08-07 refactor: thread spawn method
2024-08-07 feat: adc test code
2024-08-08 feat: first ADC working test code.
2024-08-10 chore: added optimal voltage divider resistor's values.
    [in.kicad_sch]
2024-08-11 !feat: dropped analog buttons in favour of digital buttons and trimmer.
2024-08-12 chore: button test code.
2024-08-12 refactor: `pwm_task()`.
2024-08-12 fix: `pwm_write()`.
2024-08-12 feat: button map first code.
2024-08-12 feat: `led_gamma_correction()` first test function.
2024-08-16 feat: added PowerMonitor resistor's values.
    [control_unit.kicad_pcb, powermonitor.kicad_sch, protections.kicad_sch]
2024-08-16 feat: screw to fuse-
    [control_unit.kicad_pcb, control_unit.kicad_sch]
2024-08-17 feat: optimized size of `pwm_data_t`.
2024-08-17 chore: `pwm_led_gamma_correction`
2024-08-18 chore: removed `PWM_BIT_RES` from Kconfig.
2024-08-18 feat: multi zone buttons optimization.
2024-08-18 chore: ready to adapt the sample format to the ul_pm library.
2024-08-19 fix: ADC attenuation.
2024-08-19 fix: powermonitor lower resistor to 680ohm
    [PowerMonitor.xlsx, control_unit.kicad_pcb, powermonitor.kicad_sch]
2024-08-19 feat: adc max value instead of adc bit resolution.
2024-08-20 !feat: added sampling frequency calculator section.
    [PowerMonitor.xlsx]
2024-08-20 feat: dynamic sample index offset.
2024-08-20 !feat: first powermonitor working code.
2024-08-22 chore: disabled powermonitor.
2024-08-24 chore: device id format.
2024-08-29 feat: added emergency switches schematics.
    [emergency_switches.kicad_pcb, emergency_switches.kicad_sch]
2024-08-30 chore: added fs to partition table.
    [partitions.csv]
2024-09-02 chore: added button state log.
2024-09-06 chore: two fs partitions.
    [partitions.csv]
2024-09-09 fix: esp_err_t ret __attribute__((unused))
    [pm.c, pwm.c, rs485.c]
2024-09-10 chore: wall terminals 6 and 8
    [Mappa zone (compilato).xlsx, Mappa zone.xlsx]
2024-09-11 chore: led test.
2024-09-16 !fix: `sizeof(buffer)` doesn't work on malloc buffers.
    [ota.c, webserver.c]
2024-09-16 !feat: async OTA thread.
2024-09-16 feat: new partition table.
    [partitions.csv]
2024-09-17 !refactor: removed OTA capabilities.
    [partitions.csv]
2024-09-17 feat: fan start up.
2024-09-17 chore: tuned correction factors.
    [pm.c]
2024-09-18 feat: fan startup.
2025-04-24 chore: zone_t instead of uint8_t in pwm_write_zone()
2026-08-15 chore: zones
    [Mappa zone (compilato).xlsx]
