LoZioo/Domoticata/(notices)

Notices in the files:
src/wall_terminal/src/main.cpp:
Copyright (c) [2024] Davide Scalisi
All rights reserved.
This software is licensed under terms that can be found in the LICENSE file
